szczukot/ESP8266Zasobnik/docs/esp8266_tech.sch

## EAGLE design docs/esp8266_tech.sch (2026-11-13)

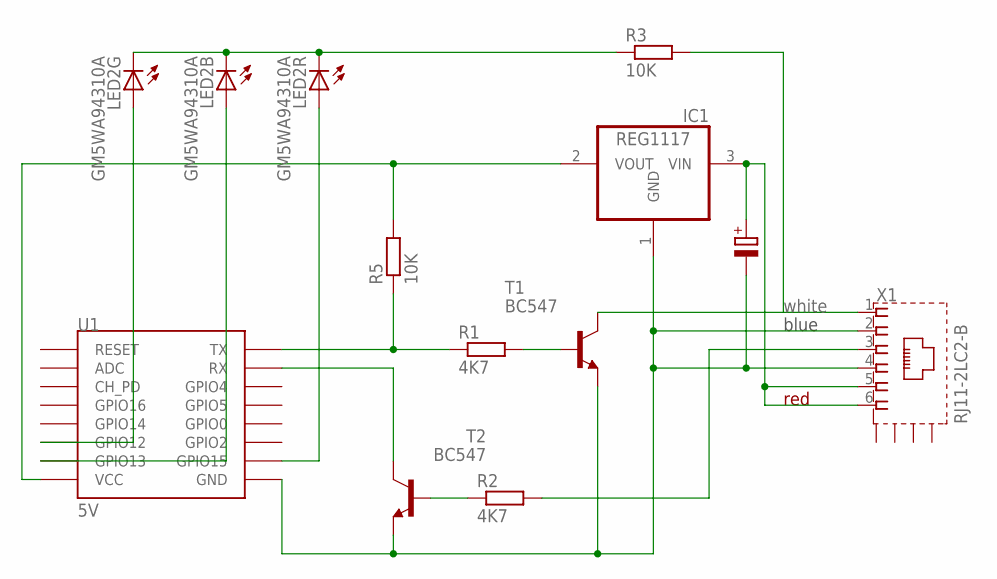
[picture p2: schematic esp8266_tech.sch]

Parts:
IC1: REG1117; SOT223
LED2: GM5WA94310A
R1, R2: 4K7; 0204V
R3, R5: 10K; 0204V
T1, T2: BC547; TO92
U1: 5V; ESP12
X1: RJ11-2LC2-B; RJ11-SHIELD2

Connections:
unnamed: R1.1, R5.1, U1.TX
unnamed: R1.2, T1.2 (B)
unnamed: T2.3 (C), U1.RX
unnamed: R2.1, T2.2 (B)
unnamed: R2.2, X1.3
unnamed: T1.3 (C), X1.1
unnamed: IC1.2 (VOUT), R5.2, U1.VCC
unnamed: IC1.3 (VIN), X1.5, X1.6
unnamed: LED2.4 (C), LED2.5 (C), LED2.6 (C), R3.1
unnamed: IC1.1 (GND), T1.1 (E), T2.1 (E), U1.GND, X1.2, X1.4
unnamed: LED2.2 (A), U1.GPIO15
unnamed: LED2.3 (A), U1.GPIO12
unnamed: LED2.1 (A), U1.GPIO13

Notes on the sheet:
blue
red
white
