szczukot/ESP8266Zasobnik/ESP8266Zasobnik/ESP8266Zasobnik.ino

#include <WiFiClient.h>
#include <stddef.h>
#include <HashMap.h>
#include <time.h>
#include <ArduinoOTA.h>              // wgrywanie z Arduino IDE przez WiFi
#include <ESP8266WebServer.h>
#include <ESP8266HTTPUpdateServer.h> // wgrywanie pliku .bin przez przegladarke
#include <ESP8266WiFi.h>
#include <PubSubClient.h> // biblioteka "PubSubClient" (Nick O'Leary)

// Tryby testowe (odkomentuj jeden lub oba):
// DEBUG    - dodatkowe komunikaty w MQTT na temat tech_solar/debug
//            (NIE na Serial - Serial jest podlaczony do sterownika TECH!)
// SIMULATE - zamiast czytac sterownik, co 5 s generuje sztuczna ramke z poprawnym CRC.
//            Mozna sprawdzic MQTT i Home Assistant bez podlaczania do TECH.
//#define DEBUG
//#define SIMULATE
// RAW_ENTITIES - tryb rozpracowywania rejestrow: kazdy surowy rejestr na tech_solar/raw/<rejestr>
//            i jako encja diagnostyczna "Rejestr XXXX" w HA (z historia). Znane encje (temperatury,
//            uzyski, pompa...) dzialaja zawsze. Po wylaczeniu surowe rejestry nie sa wysylane,
//            a ESP raz sprzata stare encje z HA i stare tematy raw z MQTT.
#define RAW_ENTITIES

void ProcessByte(int przeslanyBajt);
void SimulateTECH();
void DebugLog(String msg);

#ifdef DEBUG
#define DBG(msg) DebugLog(msg)
#else
#define DBG(msg)
#endif

// definicje sieci WiFi
#include "secrets.h" // hasla - plik poza repo, wzor w secrets.h.example
const char* ssid = SECRET_WIFI_SSID;
const char* password = SECRET_WIFI_PASSWORD;
#ifndef SECRET_OTA_PASSWORD
#define SECRET_OTA_PASSWORD "zmien_mnie" // dopisz wlasne haslo w secrets.h
#endif

// definicje TECH
#define TechTempSolar "1701"
#define TechTempTank "1702"
#define TechMode "1705" // 0 auto 1-odmrazanie 2-urlopowy
#define TechPumpOnOff "1744" // zasilanie pompy 
#define TechPumpPower "1757" // moc pompy
#define TechTime "1620" // czas na sterowniku
#define TechPower "1b98" // uzysk chwilowy
#define TechPowerDaily "1b99" // uzysk dzienny
#define TechEnergyWeek "1b9a" // uzysk tygodniowy, kWh bez dzielnika
#define TechEnergyMonth "1b9b" // uzysk miesieczny, kWh bez dzielnika
#define TechState "157c" // stan sterownika: 0x1E reczna, 0x62 normalna (?), 0x68 przegrzanie kolektora

//#1B98 -> Uzysk chwilowy [0051=>8.1kWh]
//#1B99 -> Uzysk dzienny [0051=>8.1kWh]
//#1B9A -> Uzysk tygodniowy [00E2=>226kWh]
//#1B9B -> Uzysk miesięczny [07F5=>2037kWh]

//157c
//1c04
//17b9 ?? data ??

// definicje ESP8266
#define rx_pin 3
const int ledIn = 2;
const int ledGreen = 12;
const int ledBlue = 13;
const int ledRed = 15;

// dane dla serwera HTML
String contentHTML;
volatile int countErrorCRC = 0;
volatile int countErrorStart = 0;
volatile int countErrorClientTimeout = 0;
volatile int countReceivedFrame = 0;
volatile int countPublish = 0;
volatile int countErrorMqtt = 0;
String lastLog = "";

WiFiServer server(80);
ESP8266WebServer updateServer(81);   // http://IP:81/update
ESP8266HTTPUpdateServer httpUpdater;
WiFiClient client;

// MQTT do Home Assistant
#define MQTT_BASE "tech_solar"
WiFiClient mqttNet;
PubSubClient mqtt(mqttNet);
String deviceId;
unsigned long lastMqttTry = 0;
unsigned long lastDiag = 0;

// kolejka zapisu do sterownika
struct TxCommand
{
	bool pending;
	uint16_t addr;
	uint16_t reg;
	uint16_t val;
	uint8_t gapMs;
	unsigned long since;
	bool isClock;      // zegar: wartosc liczona w chwili wysylki, na poczatku minuty
};
TxCommand txCmd = { false, 0, 0, 0, 0, 0, false };
time_t clockRecvTime = 0; // kiedy (wg NTP) przyszla ostatnia wartosc 1620
String lastTx = "-";
int countTx = 0;

// automatyczne ustawianie zegara sterownika wg NTP
#define CLOCK_MAX_DIFF_MIN 2              // od jakiej roznicy (minuty) poprawiac zegar
#define CLOCK_SYNC_MIN_INTERVAL 600000UL  // nie czesciej niz co 10 min (gdyby zapis nie dzialal)
unsigned long lastAutoClockSync = 0;

// zapis trybu pracy: odczyt 1705 = 5893 -> zapis parametru 893 = 0x037D (wg reguly, do potwierdzenia)
#define MODE_WRITE_REG 0x037D
#define MODE_VERIFY_MS 60000UL // ile czekac na potwierdzenie zmiany w 1705
struct ModeVerify
{
	int want;          // -1 = nic nie sprawdzamy
	uint16_t reg;      // rejestr, ktorym probowalismy
	unsigned long since;
};
ModeVerify modeVerify = { -1, 0, 0 };
int countAutoClockSync = 0;
// licznik zmian kazdego rejestru od startu ESP - odroznia nastawy (stale) od wartosci zmiennych
#define RAW_MAX 255 // tyle co pojemnosc mypin (sterownik wysyla ok. 200 rejestrow)
char rawKey[RAW_MAX][5];
uint16_t rawCnt[RAW_MAX];
int rawN = 0;
unsigned long rawOverflow = 0; // rejestry, ktore nie zmiescily sie w liczniku
// rejestry zapisu (< 0x1388) osobno - nie zajmuja miejsca w mypin ani w licznikach odczytu
#define WR_MAX 160
char wrKey[WR_MAX][5];
uint16_t wrVal[WR_MAX];
uint16_t wrCnt[WR_MAX];
int wrN = 0;
unsigned long wrOverflow = 0;
bool rawSummaryDirty = false;
unsigned long lastRawSummary = 0;
String rawAnnounced = ","; // rejestry, dla ktorych wyslano juz konfiguracje encji do HA
int clockDriftState = -1; // -1 nieznany, 0 OK, 1 rozjechany (wysylane tylko przy zmianie)

CreateHashMap(mypin, String, String, 255);


void setup(void)
{
	pinMode(ledGreen, OUTPUT);
	pinMode(ledRed, OUTPUT);
	pinMode(ledBlue, OUTPUT);
	pinMode(ledIn, OUTPUT);
	LEDOff(ledIn); // zgas led wbudowany

	pinMode(rx_pin, INPUT_PULLUP); // podcignij do VCC

	// wlacz czerwona diode - serwer startuje
	LEDOn(ledRed);

	// tylko client (bez AP)	
	WiFi.mode(WIFI_STA);
	WiFi.setPhyMode(WIFI_PHY_MODE_11G);
  WiFi.setHostname("ESP8266Zasobnik");
	WiFi.begin(ssid, password);

	unsigned long timeout = millis();
	// Wait for connection
	while (WiFi.status() != WL_CONNECTED)
	{
		delay(500);
		contentHTML += ".";

		if (millis() - timeout > 20000)
		{
			ESP.restart();
			return;
		}

	}

	contentHTML += "<br/>";
	contentHTML += "Connected to ";
	contentHTML += ssid;
	contentHTML += "<br/>";
	contentHTML += "IP Address ";
	contentHTML += WiFi.localIP().toString();
	contentHTML += "<br/>";

	server.begin();
	contentHTML += "HTTP server started<br/>";

	// aktualizacja przez WiFi: Arduino IDE (port sieciowy) albo przegladarka http://IP:81/update
	ArduinoOTA.setHostname("ESP8266Zasobnik");
	ArduinoOTA.setPassword(SECRET_OTA_PASSWORD);
	ArduinoOTA.onStart([]() { SendLog("OTA_start"); LEDOn(ledRed); LEDOn(ledBlue); });
	ArduinoOTA.onError([](ota_error_t e) { SendLog("OTA_blad_" + String((int)e)); LEDOff(ledBlue); });
	ArduinoOTA.begin();
	httpUpdater.setup(&updateServer, "/update", "admin", SECRET_OTA_PASSWORD);
	updateServer.begin();
	contentHTML += "OTA: Arduino IDE lub http://" + WiFi.localIP().toString() + ":81/update<br/>";

	deviceId = "tech_solar_" + String(ESP.getChipId(), HEX);
	mqtt.setServer(SECRET_MQTT_HOST, SECRET_MQTT_PORT);
	mqtt.setBufferSize(1024); // konfiguracja autowykrywania HA nie miesci sie w domyslnych 256 B
	mqtt.setCallback(MqttCallback);

	// czas z NTP (do ustawiania zegara sterownika), strefa Polska z czasem letnim
	configTime("CET-1CEST,M3.5.0,M10.5.0/3", "pool.ntp.org");

	Serial.setRxBufferSize(1024); // HTTP blokuje petle - wiekszy bufor, zeby nie gubic bajtow
	Serial.begin(9600);
//	txSerial.begin(9600);


	// wszystko wystartowalo - wylacz czerwona diode
	LEDOff(ledRed);

	SendLog("Start");
}


void loop(void)
{
	ArduinoOTA.handle();
	updateServer.handleClient();

	HandleWWWClient();

	MqttLoop();

	TxLoop();

	if (rawSummaryDirty && millis() - lastRawSummary > 10000 && mqtt.connected())
	{
		PublishRawSummary();
		rawSummaryDirty = false;
		lastRawSummary = millis();
	}

	ReadDataFromTECH();
}


String readLine = "";
unsigned long lastFrameEnd = 0; // koniec ostatniej ramki - do wyboru momentu nadawania
bool lastWasPoll = false;       // czy byla to pusta ramka zapytania 0226fff40218
String bajt2;
String key;
String value;
void ReadDataFromTECH()
{
#ifdef SIMULATE
	SimulateTECH();
#else
	if (Serial.available() > 0)
		ProcessByte(Serial.read());
#endif
}

void ProcessByte(int przeslanyBajt)
{
	{
		LEDOn(ledBlue);
		bajt2 = "";
		if (przeslanyBajt < 0)
		{
			SendLog("Bad_BYTE_" + readLine);
		}

		if (przeslanyBajt < 16)
		{
			bajt2 += "0"; //uzupelnienie
		}
		bajt2 += String(przeslanyBajt, HEX);
		readLine += bajt2;

		if (readLine.length() == 4 && readLine != "0226")
		{ // błędny początek ramki
			countErrorStart++; // bez logowania - nie blokujemy odczytu

			readLine = readLine.substring(2); // wytnij jeden bajt (2 znaki hex) i szukaj dalej poczatku ramki
		}

		if (readLine.length() >= 16 && readLine.substring(readLine.length() - 8, readLine.length() - 4) == "0218" && (readLine.length() % 8 == 0))
		{
			countReceivedFrame++;

			String frameCRC = readLine.substring(readLine.length() - 4, readLine.length());
			unsigned int testCRC = strtol(frameCRC.c_str(), NULL, 16);
			unsigned int calculatedCRC = crc16_mcrf4xx(readLine);

			if (testCRC == calculatedCRC)
		//	if (crc16_mcrf4xx(0xFFFF, (uint8_t*)readLine.c_str(), readLine.length()))
			{
				// i = 8: pomijamy naglowek 0226 + adres
				for (int i = 8; i < readLine.length() - 8; i = i + 8)
				{
					key = readLine.substring(i, i + 4);
					value = readLine.substring(i + 4, i + 8);

					// rejestry zapisu osobno (zwykle 0000, nie zasmiecaja mypin)
					if (IsWriteReg(key))
						HandleWriteReg(key, value);
					// zapisujemy wszystkie rejestry; wysylamy tylko nowe lub zmienione
					else if (mypin.indexOf(key) == -1 || mypin[key] != value)
					{
						LEDOff(ledBlue);
						SaveAndSendData(key, value);
					}
				}

			}
			else
			{
        LEDOff(ledBlue);

				SendLog("Bad_CRC_" + readLine);

				countErrorCRC++;
			}
			lastFrameEnd = millis();
			lastWasPoll = (readLine.length() == 16 && readLine.startsWith("0226fff4"));
			readLine = "";
		}

		// dla bezpieczestwa
		if (readLine.length() > 2048)
		{
      SendLog("Bad_LONGLINE_" + readLine.substring(0, 64));

			readLine = "";
		}

		LEDOff(ledBlue);
	}
}

void HandleWWWClient()
{
	client = server.available();
	if (client)
	{
		LEDOn(ledIn);

		unsigned long timeout = millis();
		while (client.available() == 0)
		{
			delay(1);
			if (millis() - timeout > 500)
			{
				countErrorClientTimeout++;
				client.stop();
				LEDOff(ledIn);
				return;
			}
		}

		// Read the first line of the request
		String req = client.readStringUntil('\r');
		DBG("WWW " + req);

		//   client.flush();

		String s = "HTTP/1.1 200 OK\r\nContent-Type: text/html\r\n\r\n<!DOCTYPE HTML>\r\n<html>";
		s += contentHTML;

		{
      int rssi = WiFi.RSSI();

			// Prepare the response
      s += "<br/>";
			s += "RSSI: " + String(rssi) + "dBm";
      s += "<br/>";
			s += "Connect quality: " + String(dBmtoPercentage(rssi)) + " %";
			s += "<br/>";
			s += "Working time: " + SystemUptime();
			s += "<br/>";
			s += "Free memory: " + String(ESP.getFreeHeap());
			s += "<br/>";
			s += "Error client timeout: " + String(countErrorClientTimeout);
			s += "<br/>";
			s += "Error CRC: " + String(countErrorCRC);
			s += "<br/>";
			s += "Error start: " + String(countErrorStart);
			s += "<br/>";
			s += "Received frames: " + String(countReceivedFrame);
			s += "<br/>";
			s += "Last log: " + lastLog;
			s += "<br/>";
			if (mqtt.connected())
				s += "MQTT: polaczony";
			else
				s += "MQTT: brak polaczenia (stan " + String(mqtt.state()) + ")";
			s += "<br/>";
			s += "MQTT wyslane: " + String(countPublish) + "   bledy polaczenia: " + String(countErrorMqtt);
			s += "<br/>";
			s += "TX: " + String(countTx) + "   ostatnia ramka: " + lastTx + (txCmd.pending ? "   (czeka w kolejce)" : "");
			s += "<br/>";
			s += "Automatyczne korekty zegara: " + String(countAutoClockSync);
			s += "<br/><br/>";
			s += ValuesHTML();
			s += RawHTML();
		}
		s += "</html>\n";

		client.flush();

		// Send the response to the client
		client.print(s);

		delay(1);

		LEDOff(ledIn);
	}
}

const int RSSI_MAX =-50;// define maximum strength of signal in dBm
const int RSSI_MIN =-100;// define minimum strength of signal in dBm
int dBmtoPercentage(int dBm)
{
  int quality;
    if(dBm <= RSSI_MIN)
    {
        quality = 0;
    }
    else if(dBm >= RSSI_MAX)
    {  
        quality = 100;
    }
    else
    {
        quality = 2 * (dBm + 100);
   }

     return quality;
}//dBmtoPercentage 

String SystemUptime()
{
	unsigned long ms = millis();
	unsigned long sec = (ms / 1000) % 60;
	int min = (ms / (1000 * 60)) % 60;
	int hour = (ms / (1000 * 60 * 60)) % 24;
	int day = (ms / (1000 * 60 * 60 * 24)) % 365;

  char buffer[25]; // Bufor na sformatowany string

  // Sformatuj poszczególne części czasu do stringów z dwoma cyframi
  sprintf(buffer, "%d days %02d:%02d:%02d", day, hour, min, sec);

  String formattedTime(buffer); // Konwertuj sformatowany string do Stringa

	return formattedTime;
}

// zwraca indeks rejestru w liczniku zmian (dodaje nowy); -1 gdy brak miejsca
int RawIndex(const String& key)
{
	for (int i = 0; i < rawN; i++)
		if (key == rawKey[i])
			return i;
	if (rawN >= RAW_MAX)
	{
		rawOverflow++;
		return -1;
	}
	strncpy(rawKey[rawN], key.c_str(), 4);
	rawKey[rawN][4] = 0;
	rawCnt[rawN] = 0;
	return rawN++;
}

void SaveAndSendData(String key, String value)
{
	// tu trafiamy tylko gdy rejestr jest nowy albo zmienil wartosc
	bool known = mypin.indexOf(key) != -1;
	int ri = RawIndex(key);
	bool summaryChanged = !known; // nowy rejestr
	if (known && ri >= 0)
	{
		if (rawCnt[ri] == 0)
			summaryChanged = true; // rejestr przeszedl ze stalych do zmiennych
		if (rawCnt[ri] < 65535)
			rawCnt[ri]++;
	}

	mypin[key] = value;
	PublishRaw(key, value, ri >= 0 ? rawCnt[ri] : 0);
	if (summaryChanged)
		rawSummaryDirty = true; // wysylane z loop() najwyzej co 10 s
	PublishValue(key, value); // znane rejestry jako encje HA

	if (key == TechTime)
	{
		clockRecvTime = time(nullptr);
		CheckControllerClock(value);
	}
	if (key == TechMode)
		CheckModeVerify(value);

	DBG("Zmiana " + key + " " + value);
}

// --- przeliczanie wartosci z TECH ---

bool IsNoSensor(const String& hex)
{
	return strtol(hex.c_str(), NULL, 16) == 0xF830; // brak czujnika
}

float HexToTemp(const String& hex)
{
	return (int16_t)strtol(hex.c_str(), NULL, 16) / 10.0; // ze znakiem - ujemne temperatury
}

long HexToLong(const String& hex)
{
	return strtol(hex.c_str(), NULL, 16);
}

String ModeName(long mode)
{
	if (mode == 0) return "auto";
	if (mode == 1) return "odmrażanie";
	if (mode == 2) return "urlopowy";
	return String(mode);
}

String StateName(long state)
{
	switch (state & 0xFF)
	{
		case 0x1E: return "praca ręczna";
		case 0x62: return "praca normalna";
		case 0x68: return "przegrzanie kolektora";
	}
	char buf[12];
	sprintf(buf, "kod 0x%02lX", state & 0xFF);
	return String(buf);
}

// rejestry ponizej 0x1388 (5000) to adresy zapisu - sterownik wysyla je zawsze z 0000,
// a odpowiadajacy im rejestr odczytu ma numer o 5000 wiekszy (np. 07DF -> 1B67)
bool IsWriteReg(const String& key)
{
	return HexToLong(key) < 0x1388;
}

String ReadRegFor(const String& key)
{
	char buf[5];
	sprintf(buf, "%04lx", HexToLong(key) + 0x1388);
	return String(buf);
}

// rejestr zapisu z ramki: zapamietuje wartosc, liczy zmiany; zmiana ma znaczenie,
// bo moze oznaczac, ze ktos (np. panel/modul) wpisal tam wartosc
void HandleWriteReg(const String& key, const String& value)
{
	uint16_t v = HexToLong(value);
	int i;
	for (i = 0; i < wrN; i++)
		if (key == wrKey[i])
			break;
	if (i == wrN)
	{
		if (wrN >= WR_MAX)
		{
			wrOverflow++;
			return;
		}
		strncpy(wrKey[i], key.c_str(), 4);
		wrKey[i][4] = 0;
		wrVal[i] = v;
		wrCnt[i] = 0;
		wrN++;
		PublishRaw(key, value, 0);
		return;
	}
	if (wrVal[i] == v)
		return;
	wrVal[i] = v;
	if (wrCnt[i] < 65535)
		wrCnt[i]++;
	PublishRaw(key, value, wrCnt[i]);
	SendLog("Rejestr_zapisu_" + key + "_" + value);
}

// rejestry podzielone na zmienne (z liczba zmian od startu), stale i adresy zapisu
String RawHTML()
{
	String var = "", cst = "", wr = "";
	for (int i = 0; i < rawN; i++)
	{
		String k = rawKey[i];
		String v = mypin.indexOf(k) != -1 ? mypin[k] : String("?");
		String up = k;
		up.toUpperCase();
		// hex, potem dziesietnie bez znaku i ze znakiem (ujemne np. temperatury)
		String line = up + " = " + v + " (" + String(HexToLong(v)) + " / " + String((int16_t)HexToLong(v)) + ")";
		if (rawCnt[i] > 0)
			var += line + " - zmian: " + String(rawCnt[i]) + "<br/>";
		else
			cst += line + "<br/>";
	}
	// pokazujemy tylko rejestry zapisu, ktore mialy wartosc inna niz 0000 - reszta jako podsumowanie
	int wrZero = 0;
	for (int i = 0; i < wrN; i++)
	{
		if (wrVal[i] == 0 && wrCnt[i] == 0)
		{
			wrZero++;
			continue;
		}
		String up = wrKey[i];
		up.toUpperCase();
		String r = ReadRegFor(wrKey[i]);
		r.toUpperCase();
		char hv[5];
		sprintf(hv, "%04x", wrVal[i]);
		wr += up + " -> zapis dla " + r;
		if (wrVal[i] != 0)
			wr += " (wartosc " + String(hv) + " = " + String(wrVal[i]) + "!)";
		if (wrCnt[i] > 0)
			wr += " - zmian: " + String(wrCnt[i]);
		wr += "<br/>";
	}
	String info = "<br/>Rejestry odczytu: " + String(rawN) + " / " + String(RAW_MAX) +
		", zapisu: " + String(wrN) + " / " + String(WR_MAX);
	if (rawOverflow || wrOverflow)
		info += " - BRAK MIEJSCA (odczyt " + String(rawOverflow) + ", zapis " + String(wrOverflow) + ")";
	return info + "<br/><b>Rejestry zmienne od startu ESP</b> (hex (bez znaku / ze znakiem)):<br/>" + var +
		"<br/><b>Rejestry stale:</b><br/>" + cst +
		"<br/><b>Rejestry zapisu</b> (odczyt = zapis + 5000):<br/>" + wr +
		String(wrZero) + " rejestrow zapisu zawsze 0000<br/>";
}

String ValuesHTML()
{
	String s;
	if (mypin.indexOf(TechTempSolar) != -1) s += "Temp. panel: " + String(HexToTemp(mypin[TechTempSolar]), 1) + " C<br/>";
	if (mypin.indexOf(TechTempTank) != -1) s += "Temp. zasobnik: " + String(HexToTemp(mypin[TechTempTank]), 1) + " C<br/>";
	if (mypin.indexOf(TechMode) != -1) s += "Tryb: " + ModeName(HexToLong(mypin[TechMode])) + "<br/>";
	if (mypin.indexOf(TechPumpOnOff) != -1) s += "Pompa: " + String(HexToLong(mypin[TechPumpOnOff]) ? "ON" : "OFF") + "<br/>";
	if (mypin.indexOf(TechPumpPower) != -1) s += "Moc pompy: " + String(HexToLong(mypin[TechPumpPower])) + " %<br/>";
	if (mypin.indexOf(TechPower) != -1) s += "Uzysk chwilowy: " + String(HexToLong(mypin[TechPower]) / 10.0, 1) + " kW<br/>";
	if (mypin.indexOf(TechPowerDaily) != -1) s += "Uzysk dzienny: " + String(HexToLong(mypin[TechPowerDaily]) / 10.0, 1) + " kWh<br/>";
	if (mypin.indexOf(TechEnergyWeek) != -1) s += "Uzysk tygodniowy: " + String(HexToLong(mypin[TechEnergyWeek])) + " kWh<br/>";
	if (mypin.indexOf(TechEnergyMonth) != -1) s += "Uzysk miesieczny: " + String(HexToLong(mypin[TechEnergyMonth])) + " kWh<br/>";
	if (mypin.indexOf(TechTime) != -1)
	{
		long v = HexToLong(mypin[TechTime]);
		char buf[64];
		sprintf(buf, "Zegar sterownika: %02ld:%02ld", (v >> 8) & 0xFF, v & 0xFF);
		s += buf;
		if (clockRecvTime > 1600000000)
		{
			// porownujemy z czasem odbioru - sterownik wysyla godzine co jakis czas,
			// wiec porownanie z "teraz" pokazywaloby sztuczna roznice
			struct tm* t = localtime(&clockRecvTime);
			sprintf(buf, " (odebrano o %02d:%02d:%02d wg NTP)", t->tm_hour, t->tm_min, t->tm_sec);
			s += buf;
		}
		s += "<br/>";
	}
	if (mypin.indexOf(TechState) != -1) s += "Stan: " + StateName(HexToLong(mypin[TechState])) + " (" + mypin[TechState] + ")<br/>";
	return s;
}

void SendLog(String msg)
{
	msg += "_free_" + String(ESP.getFreeHeap());
	lastLog = msg;
	if (mqtt.connected())
		mqtt.publish(MQTT_BASE "/log", msg.c_str());
}

// --- tryby testowe ---

void DebugLog(String msg)
{
	if (mqtt.connected())
		mqtt.publish(MQTT_BASE "/debug", msg.c_str());
}

#ifdef SIMULATE
unsigned long lastSim = 0;

// Buduje ramke jak ze sterownika: 0226 FFF4 [rejestr wartosc]... 0218 CRC
// i przepuszcza ja bajt po bajcie przez ten sam kod co prawdziwy odczyt.
void SimulateTECH()
{
	if (millis() - lastSim < 5000)
		return;
	lastSim = millis();

	unsigned long t = millis() / 5000; // krok symulacji
	int16_t tempSolar = -50 + (t * 37) % 900;   // -5,0 .. 84,9 C (sprawdza tez ujemne)
	int16_t tempTank = 300 + (t * 7) % 300;     // 30,0 .. 59,9 C
	uint16_t pumpOn = (tempSolar > tempTank + 50) ? 1 : 0;
	uint16_t pumpPower = pumpOn ? 30 + (t * 13) % 70 : 0;
	uint16_t power = pumpOn ? (t * 3) % 60 : 0;  // x0,1 kW
	uint16_t daily = (t / 4) % 300;              // x0,1 kWh

	uint16_t regs[][2] = {
		{ 0x1701, (uint16_t)tempSolar },
		{ 0x1702, (uint16_t)tempTank },
		{ 0x1705, 0 },  // tryb auto
		{ 0x1744, pumpOn },
		{ 0x1757, pumpPower },
		{ 0x1b98, power },
		{ 0x1b99, daily },
		{ 0x1b9a, (uint16_t)(20 + daily / 10) },     // tygodniowy kWh
		{ 0x1b9b, (uint16_t)(150 + daily / 10) },    // miesieczny kWh
		{ 0x1b9c, (uint16_t)(58164 + daily / 10) },  // 1B9C jak u sikor16
		{ 0x157c, (uint16_t)(tempSolar > 800 ? 0x68 : 0x62) }, // >80 C = przegrzanie
		{ 0x1ba1, (uint16_t)(t % 10) },              // nieznany - test raw
	};
	const int n = sizeof(regs) / sizeof(regs[0]);

	uint8_t frame[4 + n * 4 + 4];
	int len = 0;
	frame[len++] = 0x02; frame[len++] = 0x26;
	frame[len++] = 0xFF; frame[len++] = 0xF4;
	for (int i = 0; i < n; i++)
	{
		frame[len++] = regs[i][0] >> 8; frame[len++] = regs[i][0] & 0xFF;
		frame[len++] = regs[i][1] >> 8; frame[len++] = regs[i][1] & 0xFF;
	}

	// CRC-16/MCRF4XX z bajtow przed 0218, wysylane big-endian
	uint16_t crc = 0xFFFF;
	for (int i = 0; i < len; i++)
	{
		crc ^= frame[i];
		for (int b = 0; b < 8; b++)
			crc = (crc & 1) ? (crc >> 1) ^ 0x8408 : (crc >> 1);
	}
	frame[len++] = 0x02; frame[len++] = 0x18;
	frame[len++] = crc >> 8; frame[len++] = crc & 0xFF;

	for (int i = 0; i < len; i++)
		ProcessByte(frame[i]);
}
#endif

// --- zapis do sterownika (sprzetowy TX = GPIO1 -> T1 -> RX sterownika) ---
//
// Ramka zapisu: 02 26 | adres | rejestr | wartosc | 02 18 | CRC
// Adres 0000 = do wszystkich (wg forum). Rejestr zapisu = numer parametru,
// a rejestr odczytu = 5000 + numer parametru (np. odczyt 1620 = 5664 -> zapis 664 = 0298).
// Wysylamy ok. 50 ms po pustym zapytaniu 0226FFF40218 (wtedy magistrala jest wolna).
// Jesli sterownik nie wysyla pustych zapytan, po 20 s wysylamy 50 ms po dowolnej ramce.


uint16_t Crc16Bytes(const uint8_t* data, int len)
{
	uint16_t crc = 0xFFFF;
	for (int i = 0; i < len; i++)
	{
		crc ^= data[i];
		for (int b = 0; b < 8; b++)
			crc = (crc & 1) ? (crc >> 1) ^ 0x8408 : (crc >> 1);
	}
	return crc;
}

void QueueTx(uint16_t addr, uint16_t reg, uint16_t val, uint8_t gapMs)
{
	txCmd.addr = addr;
	txCmd.reg = reg;
	txCmd.val = val;
	txCmd.gapMs = gapMs;
	txCmd.since = millis();
	txCmd.isClock = false;
	txCmd.pending = true;

	char buf[48];
	sprintf(buf, "TX_kolejka_%04x_%04x_%04x_gap%d", addr, reg, val, gapMs);
	SendLog(buf);
}

// "RRRRVVVV" albo "RRRR VVVV [ADRES] [ODSTEP_MS]", wszystko hex poza odstepem
void QueueRaw(String p)
{
	p.trim();
	p.toLowerCase();
	String tok[4];
	int n = 0;
	if (p.length() == 8 && p.indexOf(' ') == -1)
	{
		tok[0] = p.substring(0, 4);
		tok[1] = p.substring(4, 8);
		n = 2;
	}
	else
	{
		int start = 0;
		while (n < 4 && start < (int)p.length())
		{
			int sp = p.indexOf(' ', start);
			if (sp == -1) sp = p.length();
			if (sp > start) tok[n++] = p.substring(start, sp);
			start = sp + 1;
		}
	}

	if (n < 2 || tok[0].length() != 4 || tok[1].length() != 4)
	{
		SendLog("TX_zly_format_" + p);
		return;
	}

	uint16_t reg = strtol(tok[0].c_str(), NULL, 16);
	uint16_t val = strtol(tok[1].c_str(), NULL, 16);
	uint16_t addr = (n >= 3) ? strtol(tok[2].c_str(), NULL, 16) : 0x0000;
	uint8_t gap = (n >= 4) ? tok[3].toInt() : 0;
	QueueTx(addr, reg, val, gap);
}

// Porownuje zegar sterownika (1620) z czasem z NTP i w razie roznicy ustawia go automatycznie.
void CheckControllerClock(const String& value)
{
	time_t now = time(nullptr);
	if (now < 1600000000)
		return; // brak czasu z NTP

	long v = HexToLong(value);
	int ctrlMin = ((v >> 8) & 0xFF) * 60 + (v & 0xFF);
	struct tm* t = localtime(&now);
	int ntpMin = t->tm_hour * 60 + t->tm_min;

	int diff = ntpMin - ctrlMin;
	if (diff > 720) diff -= 1440;   // przejscie przez polnoc
	if (diff < -720) diff += 1440;

	// encja "Zegar rozjechany" - tylko przy zmianie stanu
	int drift = (abs(diff) >= CLOCK_MAX_DIFF_MIN) ? 1 : 0;
	if (drift != clockDriftState && mqtt.connected())
	{
		mqtt.publish(MQTT_BASE "/clock_drift", drift ? "ON" : "OFF", true);
		clockDriftState = drift;
	}

	if (txCmd.pending)
		return;
	if (lastAutoClockSync != 0 && millis() - lastAutoClockSync < CLOCK_SYNC_MIN_INTERVAL)
		return;

	if (drift)
	{
		lastAutoClockSync = millis();
		countAutoClockSync++;
		SendLog("Zegar_auto_roznica_" + String(diff) + "min");
		QueueClockSync();
	}
}

void QueueClockSync()
{
	time_t now = time(nullptr);
	if (now < 1600000000) // NTP jeszcze nie ustawil czasu
	{
		SendLog("TX_brak_czasu_NTP");
		return;
	}
	// odczyt 1620 = 5664 -> zapis parametru 664 = 0x0298; format: bajt godzina, bajt minuty.
	// Sterownik przyjmuje tylko godzine i minuty (sekundy = 0), wiec wysylamy na poczatku minuty
	// - inaczej po ustawieniu zegar od razu spozni sie o tyle sekund, ile minelo od pelnej minuty.
	txCmd.addr = 0x0000;
	txCmd.reg = 0x0298;
	txCmd.val = 0;          // wyliczane w TxLoop w chwili wysylki
	txCmd.gapMs = 0;
	txCmd.since = millis();
	txCmd.isClock = true;
	txCmd.pending = true;
	SendLog("TX_kolejka_zegar");
}

void SendFrame(uint16_t addr, uint16_t reg, uint16_t val, uint8_t gapMs)
{
	uint8_t f[12];
	f[0] = 0x02; f[1] = 0x26;
	f[2] = addr >> 8; f[3] = addr & 0xFF;
	f[4] = reg >> 8;  f[5] = reg & 0xFF;
	f[6] = val >> 8;  f[7] = val & 0xFF;
	f[8] = 0x02; f[9] = 0x18;
	uint16_t crc = Crc16Bytes(f, 8);
	f[10] = crc >> 8; f[11] = crc & 0xFF;

	LEDOn(ledGreen);
	for (int i = 0; i < 12; i++)
	{
		Serial.write(f[i]);
		if (gapMs)
		{
			Serial.flush();
			delay(gapMs);
		}
	}
	Serial.flush();
	LEDOff(ledGreen);
	countTx++;

	char hex[25];
	for (int i = 0; i < 12; i++)
		sprintf(hex + 2 * i, "%02x", f[i]);
	lastTx = String(hex);
	SendLog("TX_" + lastTx);
	if (mqtt.connected())
		mqtt.publish(MQTT_BASE "/tx", lastTx.c_str(), true);
}

void TxLoop()
{
	ModeVerifyLoop();

	if (!txCmd.pending)
		return;
	if (readLine.length() != 0 || Serial.available() > 0)
		return; // trwa odbior ramki
	if (lastFrameEnd == 0)
		return; // jeszcze nie bylo zadnej ramki

	unsigned long sinceFrame = millis() - lastFrameEnd;
	bool waitedLong = millis() - txCmd.since > 20000;
	if (!lastWasPoll && !waitedLong)
		return; // czekamy na puste zapytanie
	if (sinceFrame < 50 || sinceFrame > 500)
		return; // tylko w oknie 50-500 ms po ramce

	if (txCmd.isClock)
	{
		time_t now = time(nullptr);
		struct tm* t = localtime(&now);
		if (t->tm_sec > 10)
			return; // czekamy na poczatek nastepnej minuty
		txCmd.val = (uint16_t)((t->tm_hour << 8) | t->tm_min);
	}

	txCmd.pending = false;
	SendFrame(txCmd.addr, txCmd.reg, txCmd.val, txCmd.gapMs);
}

int ModeFromName(const String& name)
{
	if (name == "auto") return 0;
	if (name == "odmrażanie") return 1;
	if (name == "urlopowy") return 2;
	return -1;
}

void SetMode(int mode)
{
	if (mode < 0)
		return;
	modeVerify.want = mode;
	modeVerify.reg = MODE_WRITE_REG;
	modeVerify.since = millis();
	QueueTx(0x0000, MODE_WRITE_REG, mode, 0);
}

// Wywolywane gdy przyjdzie nowa wartosc 1705
void CheckModeVerify(const String& value)
{
	if (modeVerify.want < 0)
		return;
	if (HexToLong(value) == modeVerify.want)
	{
		char buf[40];
		sprintf(buf, "Tryb_ok_%d_rej_%04x", modeVerify.want, modeVerify.reg);
		SendLog(buf);
		modeVerify.want = -1;
	}
}

// Brak potwierdzenia -> druga proba zapisem wprost na 1705, potem rezygnacja
void ModeVerifyLoop()
{
	if (modeVerify.want < 0 || txCmd.pending)
		return;
	if (millis() - modeVerify.since < MODE_VERIFY_MS)
		return;

	if (modeVerify.reg == MODE_WRITE_REG)
	{
		SendLog("Tryb_brak_potwierdzenia_proba_1705");
		modeVerify.reg = 0x1705;
		modeVerify.since = millis();
		QueueTx(0x0000, 0x1705, modeVerify.want, 0);
	}
	else
	{
		SendLog("Tryb_zapis_nie_zadzialal");
		modeVerify.want = -1;
	}
}

void MqttCallback(char* topic, byte* payload, unsigned int length)
{
	String t(topic);
	String p;
	for (unsigned int i = 0; i < length; i++)
		p += (char)payload[i];

	if (t == MQTT_BASE "/cmd/sync_clock")
		QueueClockSync();
	else if (t == MQTT_BASE "/cmd/raw")
		QueueRaw(p);
	else if (t == MQTT_BASE "/cmd/mode")
		SetMode(ModeFromName(p));
}

// --- MQTT / Home Assistant ---

void MqttLoop()
{
	if (!mqtt.connected())
	{
		LEDOn(ledRed); // czerwona = brak polaczenia z MQTT
		if (millis() - lastMqttTry > 5000)
		{
			lastMqttTry = millis();
			MqttConnect();
		}
	}
	else
	{
		mqtt.loop();
		if (millis() - lastDiag > 60000)
		{
			lastDiag = millis();
			PublishDiag();
		}
	}
}

void MqttConnect()
{
	if (WiFi.status() != WL_CONNECTED)
		return;

	if (!mqtt.connect(deviceId.c_str(), SECRET_MQTT_USER, SECRET_MQTT_PASSWORD,
		MQTT_BASE "/status", 0, true, "offline"))
	{
		countErrorMqtt++;
		return;
	}

	LEDOff(ledRed);
	mqtt.publish(MQTT_BASE "/status", "online", true);
	mqtt.subscribe(MQTT_BASE "/cmd/#");
	PublishDiscovery();

	// po (ponownym) polaczeniu wyslij wszystkie znane wartosci
	const char* keys[] = { TechTempSolar, TechTempTank, TechMode, TechPumpOnOff, TechPumpPower, TechPower, TechPowerDaily,
		TechEnergyWeek, TechEnergyMonth, TechState };
	for (const char* k : keys)
	{
		if (mypin.indexOf(k) != -1)
			PublishValue(k, mypin[k]);
	}
	PublishDiag();
	rawSummaryDirty = true;
}

void PublishValue(String key, String value)
{
	if (!mqtt.connected())
		return;

	String obj;
	String payload;
	if (key == TechTempSolar || key == TechTempTank)
	{
		if (IsNoSensor(value))
			return;
		obj = (key == TechTempSolar) ? "temp_solar" : "temp_tank";
		payload = String(HexToTemp(value), 1);
	}
	else if (key == TechMode)
	{
		obj = "mode";
		payload = ModeName(HexToLong(value));
	}
	else if (key == TechPumpOnOff)
	{
		obj = "pump";
		payload = HexToLong(value) ? "ON" : "OFF";
	}
	else if (key == TechPumpPower)
	{
		obj = "pump_power";
		payload = String(HexToLong(value));
	}
	else if (key == TechPower)
	{
		obj = "power";
		payload = String(HexToLong(value) / 10.0, 1);
	}
	else if (key == TechPowerDaily)
	{
		obj = "energy_daily";
		payload = String(HexToLong(value) / 10.0, 1);
	}
	else if (key == TechEnergyWeek)
	{
		obj = "energy_week";
		payload = String(HexToLong(value));
	}
	else if (key == TechEnergyMonth)
	{
		obj = "energy_month";
		payload = String(HexToLong(value));
	}
	else if (key == TechState)
	{
		obj = "state";
		payload = StateName(HexToLong(value));
	}
	else
	{
		return;
	}

	LEDOn(ledGreen);
	String topic = String(MQTT_BASE "/") + obj;
	mqtt.publish(topic.c_str(), payload.c_str(), true);
	LEDOff(ledGreen);
	countPublish++;
}

void PublishRaw(String key, String value, uint16_t changes)
{
	if (!mqtt.connected())
		return;

	String topic = String(MQTT_BASE "/raw/") + key;
	String obj = "raw_" + key;

#ifndef RAW_ENTITIES
	// wylaczone - nic nie wysylamy; tylko raz na rejestr sprzatamy to,
	// co zostalo po wczesniejszym wlaczeniu (encja w HA i temat raw w MQTT)
	if (rawAnnounced.indexOf("," + key + ",") == -1)
	{
		mqtt.publish(String("homeassistant/sensor/" + deviceId + "/" + obj + "/config").c_str(), "", true);
		mqtt.publish(topic.c_str(), "", true);
		rawAnnounced += key + ",";
	}
	return;
#endif

	// tryb rozpracowywania rejestrow - kazdy rejestr na tech_solar/raw/<rejestr>
	// i jako encja diagnostyczna w HA, wiec w historii widac kiedy i jak sie zmienial
	String payload = "{\"hex\":\"" + value + "\",\"u\":" + String(HexToLong(value)) +
		",\"s\":" + String((int16_t)HexToLong(value)) + ",\"zmiany\":" + String(changes) + "}";
	mqtt.publish(topic.c_str(), payload.c_str(), true);

	if (rawAnnounced.indexOf("," + key + ",") != -1)
		return;
	// zegar bez encji - zmienia sie co minute i tylko zasmiecalby historie;
	// rejestry zapisu bez encji - zawsze 0000 (usuwamy encje z wczesniejszych wersji)
	if (key == TechTime || IsWriteReg(key))
	{
		mqtt.publish(String("homeassistant/sensor/" + deviceId + "/" + obj + "/config").c_str(), "", true);
		rawAnnounced += key + ",";
		return;
	}
	String name = "Rejestr " + key;
	name.toUpperCase();
	name.replace("REJESTR", "Rejestr");
	String extra = String(",\"val_tpl\":\"{{ value_json.u }}\",\"json_attr_t\":\"" MQTT_BASE "/raw/") + key +
		"\",\"stat_cla\":\"measurement\",\"ent_cat\":\"diagnostic\",\"ic\":\"mdi:memory\"";
	PublishDiscoveryEntity("sensor", obj.c_str(), name.c_str(), ("raw/" + key).c_str(), extra.c_str());
	rawAnnounced += key + ",";
}

// lista rejestrow zmiennych (z liczba zmian) i stalych - encja "Rejestry zmienne" w HA
void PublishRawSummary()
{
#ifdef RAW_ENTITIES
	if (!mqtt.connected())
		return;
	int nVar = 0, nConst = 0;
	String var = "", cst = "";
	for (int i = 0; i < rawN; i++)
	{
		String k = rawKey[i];
		if (k == TechTime || IsWriteReg(k))
			continue; // zegar wiadomo ze sie zmienia, rejestry zapisu zawsze 0000
		k.toUpperCase();
		if (rawCnt[i] > 0)
		{
			if (nVar) var += " ";
			var += k;
			nVar++;
		}
		else
		{
			if (nConst) cst += " ";
			cst += k;
			nConst++;
		}
	}
	String j = "{\"zmienne\":" + String(nVar) + ",\"stale\":" + String(nConst) +
		",\"lista_zmienne\":\"" + var + "\",\"lista_stale\":\"" + cst + "\"}";
	mqtt.publish(MQTT_BASE "/raw_summary", j.c_str(), true);
#endif
}

void PublishDiag()
{
	if (!mqtt.connected())
		return;

	String j = "{\"rssi\":" + String(WiFi.RSSI()) +
		",\"uptime\":" + String(millis() / 1000) +
		",\"heap\":" + String(ESP.getFreeHeap()) +
		",\"frames\":" + String(countReceivedFrame) +
		",\"crc_errors\":" + String(countErrorCRC) +
		",\"start_errors\":" + String(countErrorStart) + "}";
	mqtt.publish(MQTT_BASE "/diag", j.c_str(), true);
}

void PublishDiscoveryEntity(const char* component, const char* obj, const char* name, const char* stateTopic, const char* extra)
{
	String topic = String("homeassistant/") + component + "/" + deviceId + "/" + obj + "/config";

	String p = String("{\"name\":\"") + name + "\"";
	p += ",\"uniq_id\":\"" + deviceId + "_" + obj + "\"";
	if (stateTopic != nullptr)
		p += String(",\"stat_t\":\"" MQTT_BASE "/") + stateTopic + "\"";
	p += ",\"avty_t\":\"" MQTT_BASE "/status\"";
	p += extra;
	p += ",\"dev\":{\"ids\":[\"" + deviceId + "\"],\"name\":\"Sterownik TECH solar\",\"mf\":\"TECH\",\"mdl\":\"ST-401n\",\"sw\":\"ESP8266Zasobnik\"}";
	p += "}";

	mqtt.publish(topic.c_str(), p.c_str(), true);
}

void PublishDiscovery()
{
	PublishDiscoveryEntity("sensor", "temp_solar", "Temperatura panelu", "temp_solar",
		",\"dev_cla\":\"temperature\",\"unit_of_meas\":\"°C\",\"stat_cla\":\"measurement\"");
	PublishDiscoveryEntity("sensor", "temp_tank", "Temperatura zasobnika", "temp_tank",
		",\"dev_cla\":\"temperature\",\"unit_of_meas\":\"°C\",\"stat_cla\":\"measurement\"");
	// tryb pracy jako wybor (zamiast dawnego czujnika - usuwamy jego konfiguracje)
	mqtt.publish(String("homeassistant/sensor/" + deviceId + "/mode/config").c_str(), "", true);
	PublishDiscoveryEntity("select", "mode", "Tryb pracy", "mode",
		",\"cmd_t\":\"" MQTT_BASE "/cmd/mode\",\"ops\":[\"auto\",\"odmrażanie\",\"urlopowy\"],\"ic\":\"mdi:cog\"");
	PublishDiscoveryEntity("binary_sensor", "pump", "Pompa", "pump",
		",\"dev_cla\":\"running\",\"pl_on\":\"ON\",\"pl_off\":\"OFF\"");
	PublishDiscoveryEntity("sensor", "pump_power", "Moc pompy", "pump_power",
		",\"unit_of_meas\":\"%\",\"stat_cla\":\"measurement\",\"ic\":\"mdi:pump\"");
	PublishDiscoveryEntity("sensor", "power", "Uzysk chwilowy", "power",
		",\"dev_cla\":\"power\",\"unit_of_meas\":\"kW\",\"stat_cla\":\"measurement\"");
	PublishDiscoveryEntity("sensor", "energy_daily", "Uzysk dzienny", "energy_daily",
		",\"dev_cla\":\"energy\",\"unit_of_meas\":\"kWh\",\"stat_cla\":\"total_increasing\"");
	PublishDiscoveryEntity("sensor", "energy_week", "Uzysk tygodniowy", "energy_week",
		",\"dev_cla\":\"energy\",\"unit_of_meas\":\"kWh\",\"stat_cla\":\"total_increasing\"");
	PublishDiscoveryEntity("sensor", "energy_month", "Uzysk miesięczny", "energy_month",
		",\"dev_cla\":\"energy\",\"unit_of_meas\":\"kWh\",\"stat_cla\":\"total_increasing\"");
	PublishDiscoveryEntity("sensor", "state", "Stan sterownika", "state",
		",\"ic\":\"mdi:solar-panel\"");

	// zapis do sterownika (testy)
	PublishDiscoveryEntity("button", "sync_clock", "Ustaw zegar sterownika", nullptr,
		",\"cmd_t\":\"" MQTT_BASE "/cmd/sync_clock\",\"pl_prs\":\"PRESS\",\"ent_cat\":\"config\",\"ic\":\"mdi:clock-edit-outline\"");
	// pole testowe usuniete z HA (zapis recznie nadal mozliwy przez temat tech_solar/cmd/raw)
	mqtt.publish(String("homeassistant/text/" + deviceId + "/raw_write/config").c_str(), "", true);

	// diagnostyka
	PublishDiscoveryEntity("binary_sensor", "clock_drift", "Zegar rozjechany", "clock_drift",
		",\"dev_cla\":\"problem\",\"pl_on\":\"ON\",\"pl_off\":\"OFF\",\"ent_cat\":\"diagnostic\",\"ic\":\"mdi:clock-alert-outline\"");
	clockDriftState = -1; // po (ponownym) polaczeniu wyslij stan od nowa

	// zegar sterownika tylko na stronie WWW (zmienia sie co minute - zasmiecal historie HA)
	mqtt.publish(String("homeassistant/sensor/" + deviceId + "/clock/config").c_str(), "", true);
#ifdef RAW_ENTITIES
	PublishDiscoveryEntity("sensor", "raw_summary", "Rejestry zmienne", "raw_summary",
		",\"val_tpl\":\"{{ value_json.zmienne }}\",\"json_attr_t\":\"" MQTT_BASE "/raw_summary\",\"ent_cat\":\"diagnostic\",\"ic\":\"mdi:format-list-checks\"");
#else
	mqtt.publish(String("homeassistant/sensor/" + deviceId + "/raw_summary/config").c_str(), "", true);
	mqtt.publish(MQTT_BASE "/raw_summary", "", true);
#endif
	// 1B9C bez osobnej encji - jest wsrod surowych rejestrow (RAW_ENTITIES); usuwamy stara encje i temat
	mqtt.publish(String("homeassistant/sensor/" + deviceId + "/reg_1b9c/config").c_str(), "", true);
	mqtt.publish(MQTT_BASE "/reg_1b9c", "", true);
	PublishDiscoveryEntity("sensor", "rssi", "WiFi RSSI", "diag",
		",\"dev_cla\":\"signal_strength\",\"unit_of_meas\":\"dBm\",\"stat_cla\":\"measurement\",\"ent_cat\":\"diagnostic\",\"val_tpl\":\"{{ value_json.rssi }}\"");
	PublishDiscoveryEntity("sensor", "uptime", "Czas pracy", "diag",
		",\"dev_cla\":\"duration\",\"unit_of_meas\":\"s\",\"ent_cat\":\"diagnostic\",\"val_tpl\":\"{{ value_json.uptime }}\"");
	PublishDiscoveryEntity("sensor", "frames", "Odebrane ramki", "diag",
		",\"stat_cla\":\"total_increasing\",\"ent_cat\":\"diagnostic\",\"val_tpl\":\"{{ value_json.frames }}\"");
	PublishDiscoveryEntity("sensor", "crc_errors", "Bledy CRC", "diag",
		",\"stat_cla\":\"total_increasing\",\"ent_cat\":\"diagnostic\",\"val_tpl\":\"{{ value_json.crc_errors }}\"");
	PublishDiscoveryEntity("sensor", "start_errors", "Bledy poczatku ramki", "diag",
		",\"stat_cla\":\"total_increasing\",\"ent_cat\":\"diagnostic\",\"val_tpl\":\"{{ value_json.start_errors }}\"");
}


unsigned int crc16_mcrf4xx(String data)
{
	String frame = data.substring(0, data.length() - 8);

	unsigned int calculatedCRC = 0xFFFF;
	for (int i = 0; i < frame.length(); i = i + 2)
	{

		char du[3] = {0}; // strtol wymaga zera na koncu
		du[0] = frame[i];
		du[1] = frame[i + 1];
		calculatedCRC ^= strtol(du, NULL, 16);

		for (int j = 8; j != 0; j--)
		{
			if ((calculatedCRC & 0x0001) != 0)
			{
				calculatedCRC >>= 1;
				calculatedCRC ^= 0x8408;
			}
			else calculatedCRC >>= 1;
		}
	}

	DBG("Ramka " + data + " CRC obliczone: " + String(calculatedCRC, HEX));
	return calculatedCRC;
}

void LEDOn(int pin)
{
	if (pin == ledIn)
		digitalWrite(pin, 0);
	else
		digitalWrite(pin, 1);
}

void LEDOff(int pin)
{
	if (pin == ledIn)
		digitalWrite(pin, 1);
	else
		digitalWrite(pin, 0);
}

//uint16_t crc16_mcrf4xx(uint16_t crc, uint8_t *data, size_t len)
//{
//	if (!data || len < 0)
//		return crc;
//
//	char du[2];
//
//	len = len - 4;
//
//	while (len--) {
//
//		du[0] = *data++;
//		du[1] = *data++;
//		crc ^= strtol(du, NULL, 16);
//
//		for (int i = 0; i < 8; i++) {
//			if (crc & 1)  crc = (crc >> 1) ^ 0x8408;
//			else          crc = (crc >> 1);
//		}
//	}
//
//	*data++;
//	*data++;
//	
//	du[0] = *data++;
//	du[1] = *data++;
//
//	long frameCRC = strtol(du, NULL, 16);
//#ifdef DEBUG
//	Serial.println("frameCRC: " + String(frameCRC) + " Calculated CRC: " + String(crc, HEX));
//#endif
//	return crc;
//}
