szczukot/ESP8266Zasobnik/(commit log)

2026-11-13 Poprawki odczytu ramek z TECH
    - puste zapytanie (16 znaków) było pomijane i psuło następną ramkę: > 16 -> >= 16
    - zły początek ramki wycina 2 znaki (1 bajt) zamiast 1 - koniec rozjechanej długości
    - Bad_START tylko liczony (licznik na stronie WWW), bez blokującego GET
    - bufor RX UART 1024 B
    - ujemne temperatury (int16_t), pominięcie F830 = brak czujnika
    - CRC: bufor strtol z zerem na końcu
    - osobny WiFiClient dla HTTP
    - usunięte zbędne liczenie CRC w obsłudze WWW
    - Bad_LONGLINE wysyła tylko 64 znaki
    Claude-Session: https://claude.ai/code/session_01Y8Xp1UacRhqHTt3Z5HW2ym
2026-11-13 MQTT z autowykrywaniem w Home Assistant
    - PubSubClient, dane logowania w secrets.h
    - wartości w tematach tech_solar/<nazwa> (retained), dostępność tech_solar/status
    - autowykrywanie HA: temperatury, tryb, pompa, moc pompy, uzysk chwilowy i dzienny
    - diagnostyka co 60 s (RSSI, czas pracy, ramki, błędy CRC) jako encje diagnostyczne
    - logi do tech_solar/log
    - nieblokujące ponawianie połączenia co 5 s, czerwona dioda = brak MQTT
    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
2026-11-13 Zapis do sterownika przez sprzętowy UART: zegar i testowy zapis rejestru
    - usunięty bit-bang na GPIO14 (nie był podłączony) i stary zakomentowany /set
    - nadawanie Serial.write na TX (GPIO1) -> T1 -> RX sterownika, bez programowej inwersji
    - ramka na adres 0000, wysyłana 50-500 ms po pustym zapytaniu 0226fff40218
    (po 20 s bez zapytania - po dowolnej ramce)
    - przycisk HA 'Ustaw zegar sterownika': czas z NTP -> rejestr 0298 (parametr 664,
    odczyt 1620 = 5664)
    - pole HA 'Zapis rejestru (test)': dowolny rejestr/wartość, opcjonalnie adres i odstęp między bajtami
    - encja 'Zegar sterownika' z rejestru 1620 (hh:mm)
    Claude-Session: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
2026-11-13 Aktualizacja firmware przez WiFi (OTA)
    - ArduinoOTA: port sieciowy w Arduino IDE (ESP8266Zasobnik), z hasłem
    - ESP8266HTTPUpdateServer: wgrywanie pliku .bin przez przeglądarkę, http://IP:81/update (admin)
    - hasło SECRET_OTA_PASSWORD w secrets.h
    - czerwona+niebieska dioda podczas aktualizacji
    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
2026-11-13 Plik EAGLE schematu i wyprowadzenia Witty Cloud
    - docs/esp8266_tech.sch (EAGLE 9.7)
    - docs/witty-cloud-pinout.jpg
    - README: uwagi do schematu (R3 pin 2 niepodłączony, IC1 = stabilizator Witty, C1 = 100 µF)
    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
    [esp8266_tech.sch]
2026-11-13 Encja 'Zegar rozjechany' (problem) w HA
    - ON gdy zegar sterownika różni się od NTP o >= CLOCK_MAX_DIFF_MIN, inaczej OFF
    - wysyłana tylko przy zmianie stanu (i po ponownym połączeniu z MQTT)
    - automatyczna korekta bez zmian - encja zwykle na chwilę pokaże ON, a po korekcie OFF
    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
    [ESP8266Zasobnik.ino]
2026-11-14 WWW: rejestry zapisu tylko te z wartością ≠ 0000, reszta jako liczba (#26)
    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
